UNIT-Electronics-MX/unit_pulsar_esp32_c5/tools/product-reference/chapters/00-description.md

## **Description**

The UNIT PULSAR ESP32-C5 is a multi-interface development board in the UNIT
DevLab ecosystem, built around the Espressif ESP32-C5HR8 SoC with 8 MB of
in-package PSRAM. The V1.2.3 design combines dual-band 2.4/5 GHz Wi-Fi 6,
Bluetooth LE, and IEEE 802.15.4 connectivity with external QSPI flash,
environmental and magnetic sensing, microSD, USB-C, Li-ion charging with fuel
gauging, an addressable RGB indicator, QWIIC I2C, and an RF coaxial antenna
connector.

### **Applications**

- Dual-band Wi-Fi 6, Bluetooth LE, Zigbee, and Thread prototyping
- Environmental monitoring and data logging
- Battery-powered IoT nodes with fuel gauging
- Magnetometer and proximity-based user interfaces
- microSD data logging
- Education and subsystem validation

### **Hardware Features**

- ESP32-C5HR8 SoC: 32-bit RISC-V up to 240 MHz, 384 KB HP SRAM, 8 MB PSRAM
- BY25Q64ES 64 Mbit (8 MiB) quad SPI NOR flash
- 2.4/5 GHz RF path through a diplexer to a coaxial antenna connector
- LPS22 pressure, FHT40 humidity/temperature, VCNL4040 proximity/light, and
  MMC5603NJ magnetometer sensors
- BQ24074 Li-ion charger with power path and MAX17048 fuel gauge
- SGM6029 1 A buck regulator for the 3.3 V rail
- microSD socket on SPI signals
- One WS2812 RGB LED plus power, charge, and user indicators
- USB-C, QWIIC, 6-pin SPI, battery, and Nano-style edge-pad connections
