UNIT-Electronics-MX/unit_pulsar_esp32_c5/tools/product-reference/chapters/02-ratings.md

## **2 Ratings**

This chapter defines the recommended operating conditions and electrical
characteristics of the UNIT PULSAR ESP32-C5 hardware V1.2.3. Ratings apply to
the complete board unless otherwise stated.

### **2.1 Recommended Operating Conditions** {.section-page}

The UNIT PULSAR ESP32-C5 can be powered from USB-C, VIN, or a single-cell LiPo
battery. The BQ24074 power-path charger feeds the onboard SGM6029 buck
regulator, which supplies the 3.3 V logic domain used by the ESP32-C5HR8 and
onboard peripherals.

| Parameter | Recommended operating condition | Notes |
|---|---:|---|
| USB-C input | 5 V nominal | Primary power and programming interface |
| VIN input | 5 V nominal | Joins USB VBUS through Schottky diode D4; board-level range not characterized |
| Battery input | 3.7 V nominal, 4.2 V maximum | Single-cell LiPo battery |
| Regulated logic rail | 3.3 V nominal | Generated by the onboard SGM6029 buck regulator |
| 3.3 V regulator output capability | Up to 1 A | SGM6029 component rating; shared by the SoC, peripherals, LEDs, and external 3.3 V loads |
| Battery charge current | 250 mA nominal | Set by R13 (3.57 kΩ) on the BQ24074 `ISET` pin |
| Input current limit | ≈1.4 A | Set by R12 (1.1 kΩ) on the BQ24074 `ILIM` pin |
| ESP32-C5 CPU clock | Up to 240 MHz | Firmware configurable |
| Main crystal | 48 MHz | XTAL1 |
| Internal SRAM | 384 KB HP SRAM, 16 KB LP SRAM | ESP32-C5 internal memory |
| External flash | 64 Mbit / 8 MiB | BY25Q64ESHIG |
| PSRAM | 8 MB | In-package, ESP32-C5HR8 |
| Logic level | 3.3 V | Applies to onboard digital interfaces and GPIO |

### **2.2 Power Domains and Power Distribution**

The UNIT PULSAR ESP32-C5 uses separate power domains for external supply,
battery operation, system power, and regulated 3.3 V logic.

The main power domains are:

- **USB-C / VBUS:** provides the nominal 5 V USB supply used for board power,
  programming, and battery charging. VBUS reaches the `+5V` node through
  Schottky diode D1 (SDM2U30CSP-7B, 2 A).

- **VIN:** external supply input that reaches the `+5V` node through Schottky
  diode D4 (SDM2U30CSP-7B, 2 A).

- **+5V:** input of the BQ24074 charger and power-path controller.

- **VBAT:** battery domain intended for a single-cell LiPo battery with a
  nominal voltage of 3.7 V and a maximum fully charged voltage of 4.2 V.

- **BMS_OUT:** BQ24074 power-path output used as the system supply and as the
  input of the 3.3 V buck regulator.

- **3.3 V:** regulated logic supply generated by the SGM6029. This rail powers
  the ESP32-C5HR8, external flash, sensors, fuel gauge, microSD interface,
  QWIIC and J20 connectors, RGB LED, and indicators.

The SGM6029 is rated for up to 1 A output current. This current is shared
between the ESP32-C5HR8, onboard peripherals, LEDs, and any external device
powered from the 3.3 V rail. Radio transmission produces short current peaks,
so the current available to external loads depends on the active board
configuration and application workload.

The BQ24074RGTR manages single-cell LiPo battery charging. The schematic
annotates a nominal charge current of 250 mA (`ICHRG=250mA`), set by R13. The
input current limit is set by R12. Both values may be changed by modifying the
corresponding resistor according to the BQ24074 configuration requirements.

All onboard digital interfaces operate in the 3.3 V logic domain. QWIIC, J20,
microSD, and exposed GPIO signals must therefore be used with 3.3 V-compatible
devices unless external level translation is provided.

Connector mechanical current ratings must not be interpreted as board power
ratings. Maximum usable current is also constrained by the associated PCB
traces, power path, regulator, protection components, and operating conditions.

### **2.3 Digital Interfaces**

All onboard digital peripherals are connected to the board's 3.3 V logic
domain. External logic compatibility must nevertheless be checked against the
ESP32-C5 input/output specifications and the power state of both devices.

| Interface | Board connection | Electrical note |
|---|---|---|
| Sensor I2C | GPIO2 / GPIO3 | Onboard sensors and fuel gauge; 4.7 kΩ pull-ups; strapping pins |
| QWIIC I2C | GPIO1 / GPIO6 | Connector also supplies 3.3 V and GND |
| SPI / microSD | GPIO27, GPIO7, GPIO26, GPIO23 | SCK, MOSI, MISO, microSD CS; shared with J20 |
| J20 chip select | GPIO10 | SS for an external SPI device |
| WS2812 data | GPIO0 | Drives the onboard RGB LED |
| UART0 | GPIO11 / GPIO12 | TX through 499 Ω series resistor |
| USB | GPIO13 / GPIO14 | Native USB Serial/JTAG |

### **2.4 Confirmed Component Values**

| Symbol / parameter | Value | Scope |
|---|---:|---|
| ESP32-C5 HP SRAM | 384 KB | ESP32-C5HR8 component |
| ESP32-C5 CPU clock | 240 MHz maximum | ESP32-C5HR8 component |
| In-package PSRAM | 8 MB | ESP32-C5HR8 component |
| QSPI flash capacity | 64 Mbit | IC3 |
| Buck output current | 1 A | U2 component rating |
| Charge current | 250 mA | R13 = 3.57 kΩ |
| Crystal frequency | 48 MHz | XTAL1 |
| Sensor I2C pull-ups | 4.7 kΩ | R15, R16 |

### **2.5 Application-Dependent and Uncharacterized Parameters** {.section-page}

Some electrical and performance characteristics depend on firmware
configuration, operating mode, connected peripherals, and application load.
Unless otherwise specified, these parameters should not be interpreted as
guaranteed board-level limits.

- **Available 3.3 V current for external loads:** the SGM6029 provides up to
  1 A total output current. This current is shared by the ESP32-C5HR8, radio
  transmission peaks, flash, sensors, LEDs, and external 3.3 V loads.

- **Board current consumption:** total current consumption varies with CPU
  activity, radio mode and transmit power, enabled peripherals, RGB LED
  brightness, microSD operation, and connected external devices.

- **RF performance:** radiated performance depends on the external antenna,
  cable, enclosure, and the populated matching network. It is not
  characterized at board level.

- **Low-battery operation:** the SGM6029 input is the BQ24074 system output.
  3.3 V regulation at low battery voltage is not characterized at board level.

- **GPIO electrical characteristics:** GPIO drive strength, input thresholds,
  and other pin-level electrical characteristics follow the ESP32-C5
  specifications unless a board-level circuit modifies the corresponding
  signal.

- **Environmental characteristics:** board-level operating temperature,
  humidity, ESD immunity, and thermal performance are not specified unless
  explicitly stated in a released qualification or validation specification.

### **2.6 Electrical Precautions** {.section-page}

1. Use only the specified power inputs: 5 V nominal through USB-C or VIN, or a
   3.7 V nominal / 4.2 V maximum single-cell LiPo battery.

2. All GPIO and onboard digital interfaces operate in the 3.3 V logic domain.
   **Do not apply 5 V directly to GPIO, QWIIC, J20, microSD, or other 3.3 V
   signal lines.**

3. Observe the battery connector polarity before connecting a single-cell LiPo
   battery. Do not connect multi-cell battery packs or batteries exceeding
   4.2 V. Do not connect batteries to JP1 and J3 at the same time; both
   connectors are wired in parallel.

4. Do not externally drive the 3.3 V rail while the onboard regulator is active
   unless the external power source and operating configuration have been
   specifically designed for this purpose.

5. Connect external circuits to a common ground before applying external clock,
   data, or control signals.

6. Do not hold GPIO2, GPIO3, GPIO7, GPIO25, GPIO26, GPIO27, or GPIO28 at a
   level that changes the boot configuration during reset; these are ESP32-C5
   strapping pins.

7. Connect an antenna to J2 before enabling radio transmission.

8. Ensure that the total load on the 3.3 V rail, including onboard circuitry
   and externally connected devices, remains within the 1 A capability of the
   SGM6029 regulator.
