UNIT-Electronics-MX/unit_pulsar_esp32_c5/tools/product-reference/chapters/08-references.md

## **8 Reference Documentation**

The following resources provide the official hardware, software, and
application documentation for the UNIT PULSAR ESP32-C5.

| Reference | Location |
|---|---|
| Product repository | [UNIT-Electronics-MX/unit_pulsar_esp32_c5](https://github.com/UNIT-Electronics-MX/unit_pulsar_esp32_c5) |
| Hardware reference | [hardware/README.md](https://github.com/UNIT-Electronics-MX/unit_pulsar_esp32_c5/blob/main/hardware/README.md) |
| Technical wiki | [PULSAR ESP32-C5 Wiki](https://github.com/UNIT-Electronics-MX/unit_pulsar_esp32_c5/wiki) |
| Board schematic | [Hardware V1.2.3 schematic](https://github.com/UNIT-Electronics-MX/unit_pulsar_esp32_c5/blob/main/hardware/unit_sch_v_1_2_3_ue0134_pulsar_esp32_c5.pdf) |
| ESP32-C5 component datasheet | [Espressif ESP32-C5 Series Datasheet](https://documentation.espressif.com/esp32-c5_datasheet_en.pdf) |
| Arduino core | [Espressif Arduino-ESP32](https://github.com/espressif/arduino-esp32) |

The UNIT Electronics Wiki provides application-oriented documentation, setup
procedures, peripheral usage examples, and software workflows for the board.

The hardware schematic and this Product Reference define the board-level
implementation, connections, power architecture, interfaces, and hardware
characteristics. ESP32-C5HR8 device-level electrical characteristics and
processor specifications should be referenced from the official Espressif
ESP32-C5 datasheet.
