UNIT-Electronics-MX/unit_pulsar_esp32_c5/docs/hardware/index.html

UNIT Electronics · DevLab

# UNIT PULSAR ESP32-C5

Direct links to hardware documentation and product files for use in external platforms.

26 files 12 images 7 formats 70.8 MB total

Search hardware resources

## Product documents

5 files

DOCX 934.2 KB

### Product Reference

Editable product reference

unit_product_reference_v_0_1_0_pulsar_esp32_c5.docx

Copy link Open file

PDF 1.1 MB

### Product Reference

Publication-ready product reference

unit_product_reference_v_0_1_0_pulsar_esp32_c5.pdf

Copy link Open file

PDF 187.7 KB

### Schematic

Electrical schematic

unit_sch_v_1_2_3_ue0134_pulsar_esp32_c5.pdf

Copy link Open file

PNG 605.3 KB

### Schematic

Electrical schematic

resources/unit_schematic_v_1_2_3_pulsar_esp32_c5_sheet_1.png

Copy link Open file

PNG 341.8 KB

### Schematic

Electrical schematic

resources/unit_schematic_v_1_2_3_pulsar_esp32_c5_sheet_2.png

Copy link Open file

## Pinouts

12 files

PDF 1.7 MB

### Pinout — English

Connector and signal reference in English

unit_btm_pinout_v1_2_3_ue0134_devlab_pulsar_esp32_c5_en.pdf

Copy link Open file

PDF 6.9 MB

### Pinout — English

Connector and signal reference in English

unit_pinout_v1_2_3_ue0134_devlab_pulsar_esp32_c5_en.pdf

Copy link Open file

PDF 5.3 MB

### Pinout — English

Connector and signal reference in English

unit_top_pinout_v1_2_3_ue0134_devlab_pulsar_esp32_c5_en.pdf

Copy link Open file

PNG 537.9 KB

### Pinout — English

Connector and signal reference in English

resources/unit_btm_pinout_v1_2_3_ue0134_devlab_pulsar_esp32_c5_en.png

Copy link Open file

PNG 4.5 MB

### Pinout — English

Connector and signal reference in English

resources/unit_pinout_v1_2_3_ue0134_devlab_pulsar_esp32_c5_en.png

Copy link Open file

PNG 805.6 KB

### Pinout — English

Connector and signal reference in English

resources/unit_top_pinout_v1_2_3_ue0134_devlab_pulsar_esp32_c5_en.png

Copy link Open file

PDF 1.7 MB

### Pinout — Spanish

Connector and signal reference in Spanish

unit_btm_pinout_v1_2_3_ue0134_devlab_pulsar_esp32_c5_es.pdf

Copy link Open file

PDF 4.8 MB

### Pinout — Spanish

Connector and signal reference in Spanish

unit_pinout_v1_2_3_ue0134_devlab_pulsar_esp32_c5_es.pdf

Copy link Open file

PDF 5.4 MB

### Pinout — Spanish

Connector and signal reference in Spanish

unit_top_pinout_v1_2_3_ue0134_devlab_pulsar_esp32_c5_es.pdf

Copy link Open file

PNG 546.6 KB

### Pinout — Spanish

Connector and signal reference in Spanish

resources/unit_btm_pinout_v1_2_3_ue0134_devlab_pulsar_esp32_c5_es.png

Copy link Open file

PNG 4.5 MB

### Pinout — Spanish

Connector and signal reference in Spanish

resources/unit_pinout_v1_2_3_ue0134_devlab_pulsar_esp32_c5_es.png

Copy link Open file

PNG 815.4 KB

### Pinout — Spanish

Connector and signal reference in Spanish

resources/unit_top_pinout_v1_2_3_ue0134_devlab_pulsar_esp32_c5_es.png

Copy link Open file

## Board views

5 files

PNG 1.5 MB

### Board Topology

Functional board layout

resources/unit_topology_v1_2_3_ue0134_devlab_pulsar_esp32_c5.png

Copy link Open file

PNG 940.6 KB

### Bottom View

Bottom-side board view

resources/unit_btm_v1_2_3_ue0134_devlab_pulsar_esp32_c5.png

Copy link Open file

PDF 349.4 KB

### Mechanical Dimensions

Board outline and dimensions

unit_dimensions_v1_2_3_ue0134_devlab_pulsar_esp32_c5.pdf

Copy link Open file

PNG 833.3 KB

### Mechanical Dimensions

Board outline and dimensions

resources/unit_dimensions_v1_2_3_ue0134_devlab_pulsar_esp32_c5.png

Copy link Open file

PNG 906.7 KB

### Top View

Top-side board view

resources/unit_top_v1_2_3_ue0134_devlab_pulsar_esp32_c5.png

Copy link Open file

## CAD and design files

2 files

IGES 12.5 MB

### 3D CAD Model

IGES mechanical model

resources/mechanics/unit_3d_v1_2_3_ue0134_devlab_pulsar_esp32_c5.iges

Copy link Open file

STEP 6.7 MB

### 3D CAD Model

STEP mechanical model

resources/mechanics/unit_3d_v1_2_3_ue0134_devlab_pulsar_esp32_c5.step

Copy link Open file

## Other resources

2 files

MD 7.4 KB

### Hardware README

Hardware overview and source notes

README.md

Copy link Open file

F3D 6.6 MB

### Unit 3D V1 2 3 Ue0134 Devlab Pulsar Esp32 C5

Hardware resource

resources/mechanics/unit_3d_v1_2_3_ue0134_devlab_pulsar_esp32_c5.f3d

Copy link Open file

No resources match your search.

UNIT Electronics hardware resources
