UNIT-Electronics-MX/unit_pulsar_esp32_c5/docs/hardware/resources/unit_top_pinout_v1_2_3_ue0134_devlab_pulsar_esp32_c5_es.png

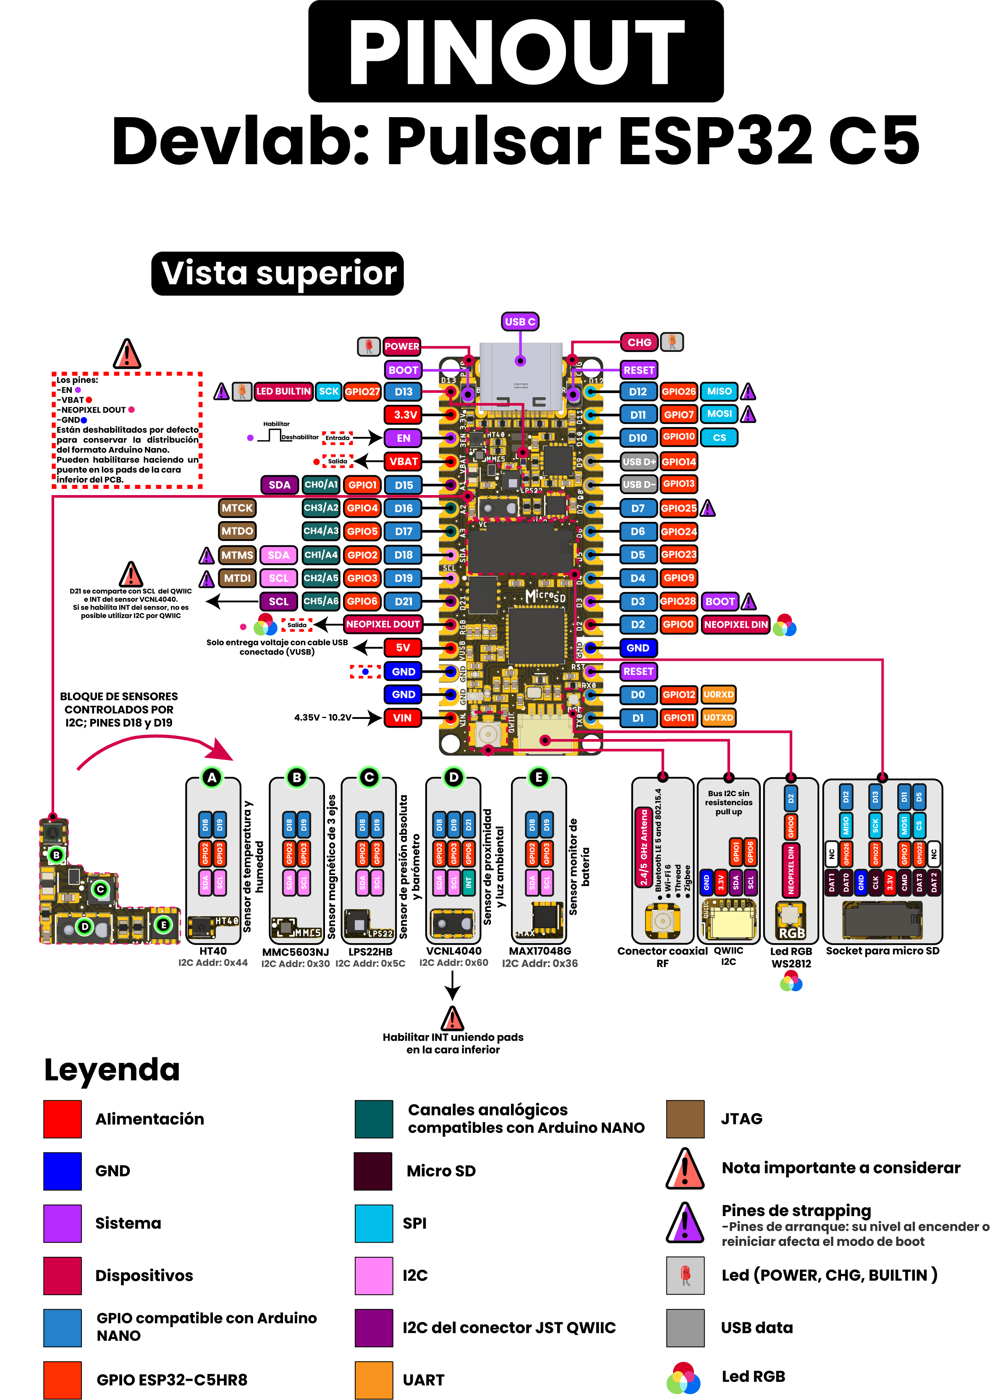
docs/hardware/resources/unit_top_pinout_v1_2_3_ue0134_devlab_pulsar_esp32_c5_es.png
