UNIT-Electronics-MX/unit_pulsar_esp32_c5/hardware/resources/unit_dimensions_v1_2_3_ue0134_devlab_pulsar_esp32_c5.png

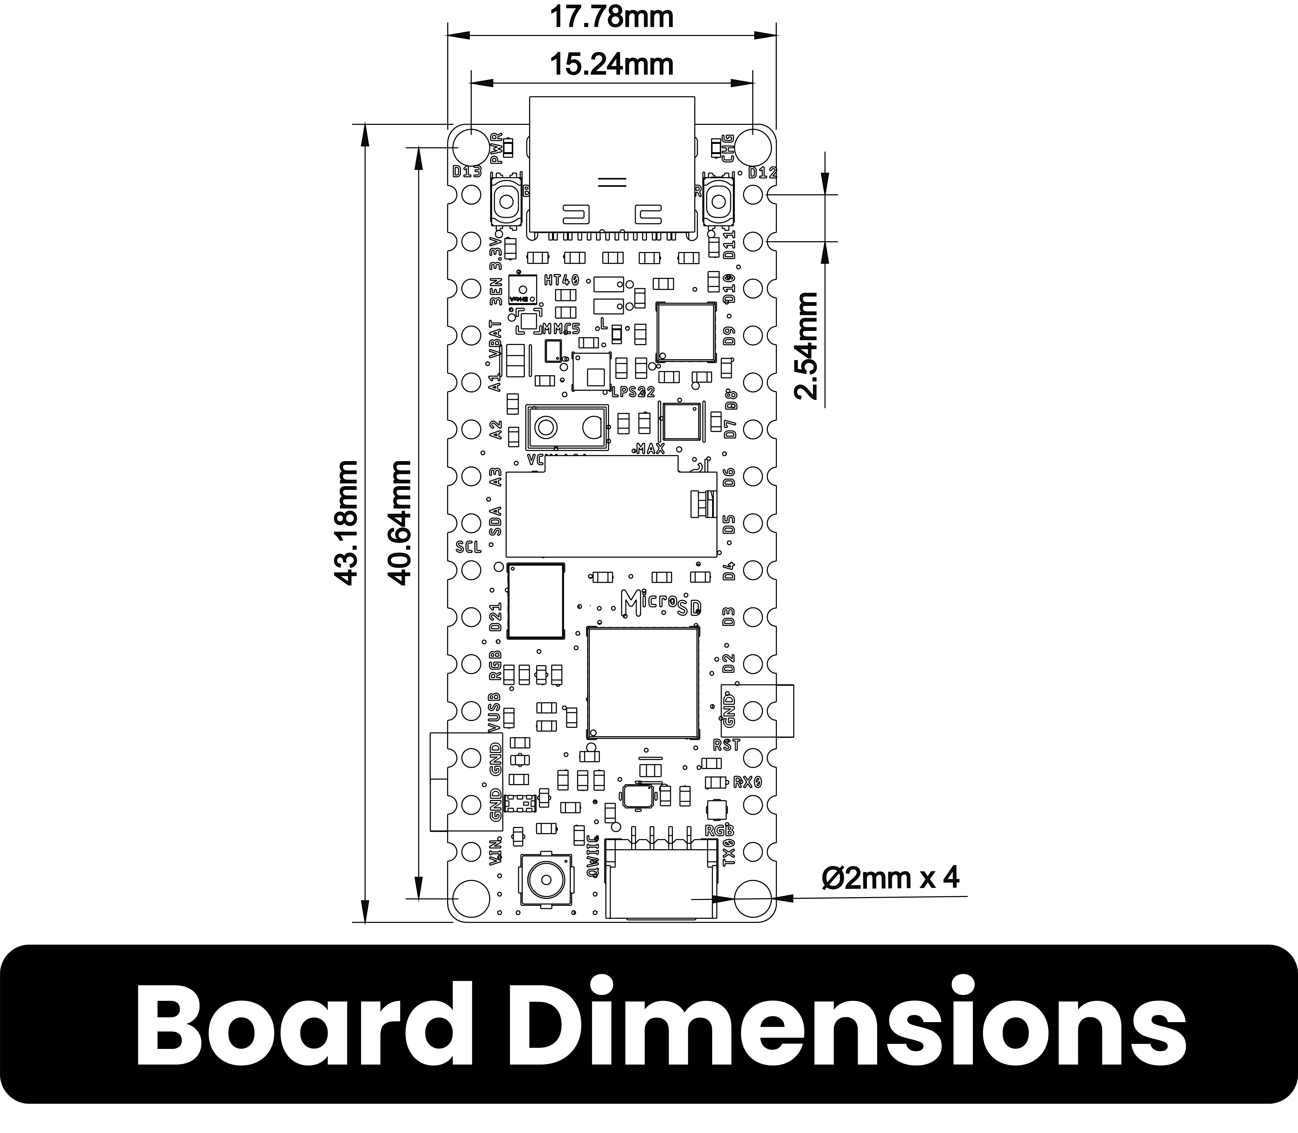
hardware/resources/unit_dimensions_v1_2_3_ue0134_devlab_pulsar_esp32_c5.png
