UNIT-Electronics-MX/unit_pulsar_esp32_c5/docs/hardware/resources/mechanics/unit_3d_v1_2_3_ue0134_devlab_pulsar_esp32_c5.step

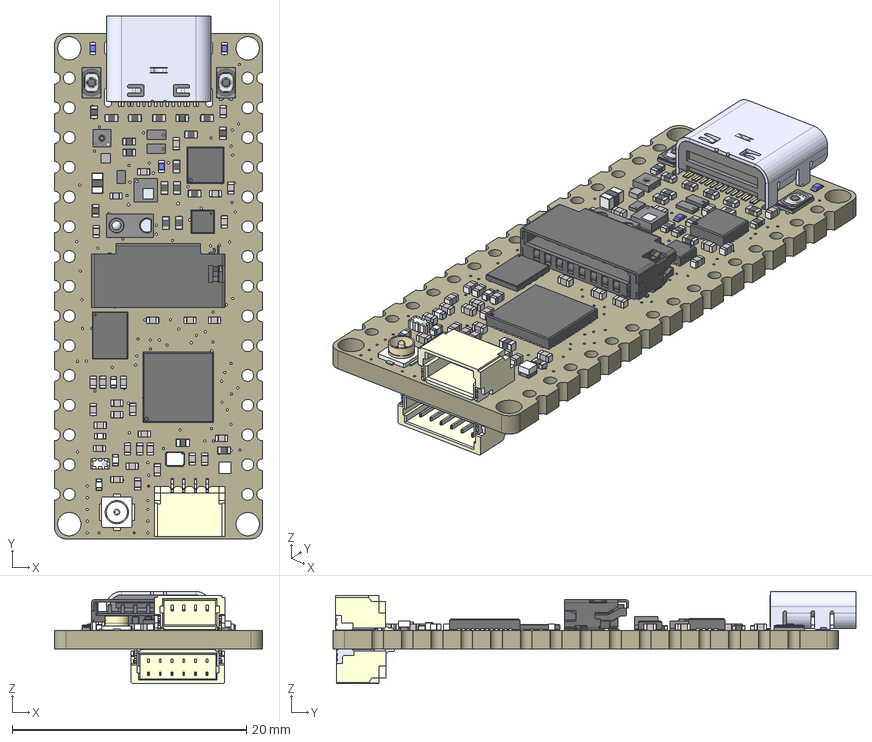
[picture p10: CAD file, 2026-11-13]
docs/hardware/resources/mechanics/unit_3d_v1_2_3_ue0134_devlab_pulsar_esp32_c5.step
17.8 x 44.7 x 7.88 mm
Placa
WLCSP-6_L1.0-W0.7-R2-C3-P0.35-BL~WLCSP-6_L1.0-W0.7-R2-C3-P0.35-BL~GQN I
SENSORS-SMD_VCNL4040M3OE~SENSORS-SMD_L4.0-W2.0-H1.1-P1.08~xvrE
USB_C_TYPE-C-31-M-12 v1
47309-2651 v1
SM04B-SRSS-TB(LF)(SN)--3DModel-STEP-56544 v1
IPEX-SMD_4P-L2.6-W2.6-LS3.0~IPEX-SMD_4P-L2.6-W2.6-LS3.0~v6XO
EVP-BB2A9B000 v1 x 2
XL-1010RGBC-WS2812B--3DModel-STEP-510211 v1
R0402 x 16
LPS22DFTR--3DModel-STEP-510211 v1
SHT40-AD1B-R2 v1
0402_R x 2
MMC5603NJ v1
SM06B-SRSS-TB(LF)(SN)--3DModel-STEP-269445
