UNIT-Electronics-MX/unit_pulsar_esp32_c5/(list of files, cad)

Other CAD files:
docs/hardware/resources/mechanics/unit_3d_v1_2_3_ue0134_devlab_pulsar_esp32_c5.f3d
docs/hardware/resources/mechanics/unit_3d_v1_2_3_ue0134_devlab_pulsar_esp32_c5.iges
