UNIT-Electronics-MX/unit_pulsar_esp32_c5/hardware/unit_btm_pinout_v1_2_3_ue0134_devlab_pulsar_esp32_c5_es.pdf

# Vista inferior

# PINOUT

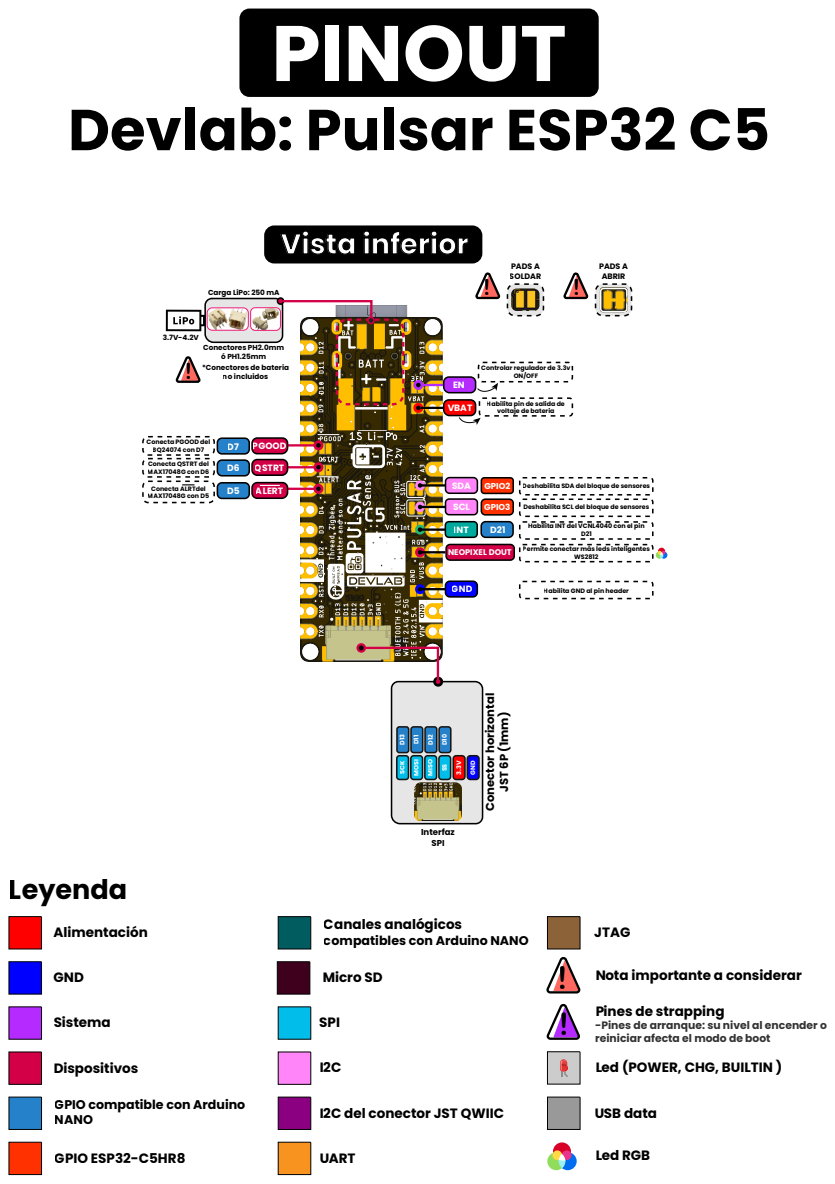
[picture p11: page 1]
EN VBAT; PADS A SOLDAR; Alimentación; GND; Sistema; SPI; USB data; UART; Led RGB; Conectores PH2.0mm ó PH1.25mm *Conectores de bateria no incluidos; Leyenda; Interfaz SPI; Devlab: Pulsar ESP32 C5 D¹² D¹⁰ 3.3V GND SS MISO D¹³ D¹¹ SCK MOSI; Conector horizontal JST 6P ⁽¹mm⁾; PGOOD; Carga LiPo: 250 mA; PADS A ABRIR; QSTRT; ALERT; SDA; SCL GPIO3; GPIO2; INT

Controlar regulador de 3.3v
ON/OFF

Habilita pin de salida de
voltaje de bateria

Conecta PGOOD del
BQ24074 con D7
D6 Conecta QSTRT del
MAX17048G con D6
D5 Conecta ALRTdel
MAX17048G con D5

Deshabilita SDA del bloque de sensores
Deshabilita SCL del bloque de sensores
Habilita INT del VCNL4040 con el pin

NEOPIXEL DOUT Permite conectar más leds inteligentes

Habilita GND al pin header

Canales analógicos
compatibles con Arduino NANO
Micro SD

JTAG
Nota importante a considerar
Pines de strapping
-Pines de arranque: su nivel al encender o
reiniciar afecta el modo de boot
Led (POWER, CHG, BUILTIN )

Dispositivos
GPIO compatible con Arduino
NANO
GPIO ESP32-C5HR8

I2C del conector JST QWIIC
