UNIT-Electronics-MX/unit_pulsar_esp32_c5/hardware/unit_pinout_v1_2_3_ue0134_devlab_pulsar_esp32_c5_es.pdf

### PADS A SOLDAR

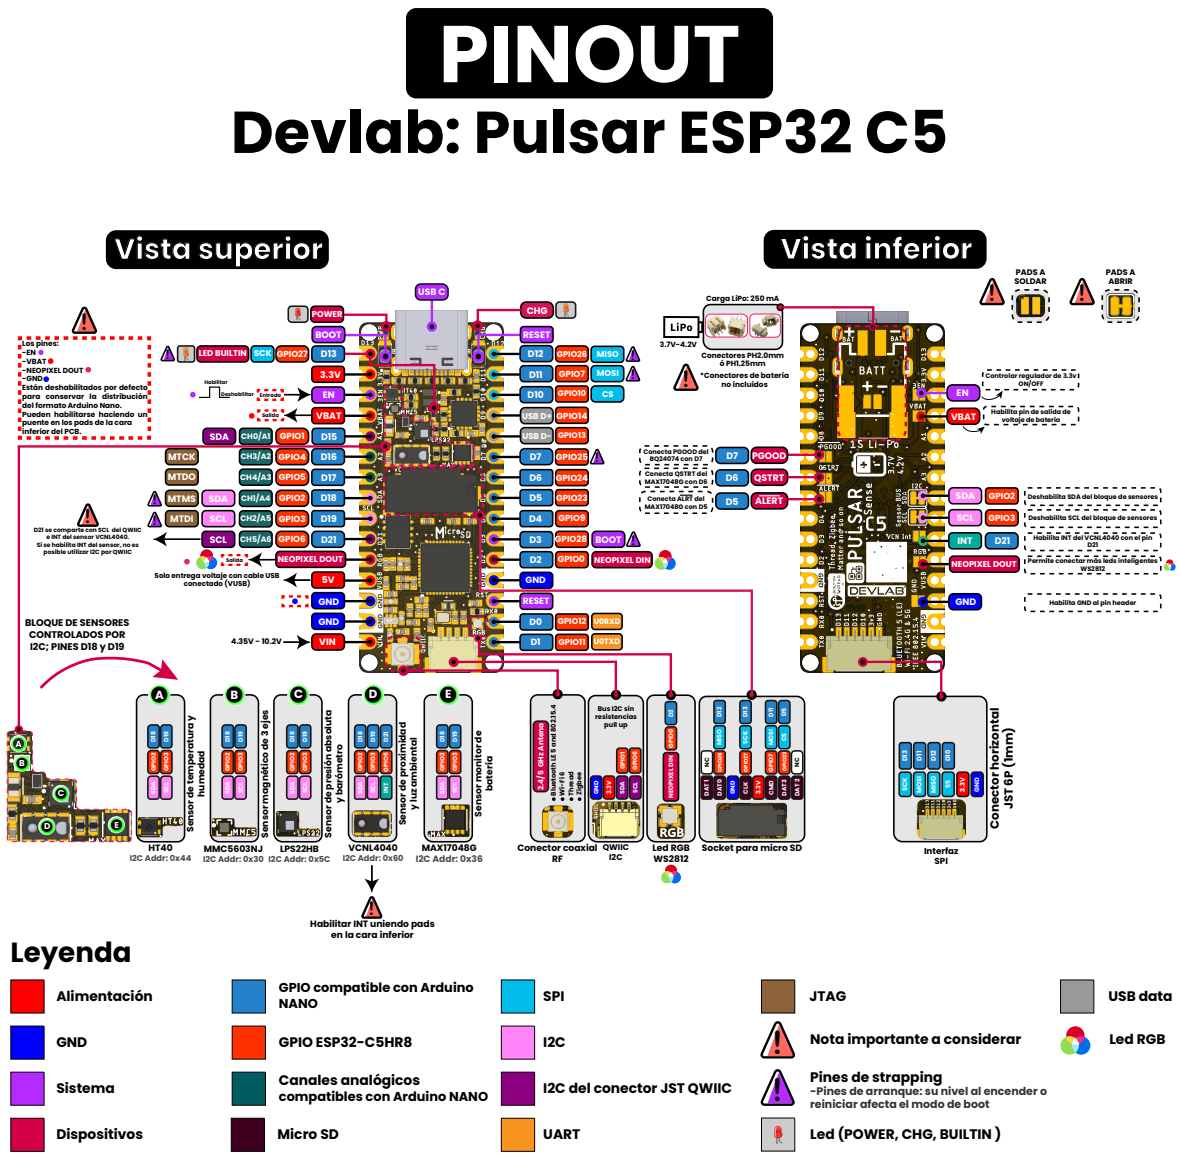
[picture p12: page 1]

PINOUT
Devlab: Pulsar ESP32 C5 GPIO⁰ D² NEOPIXEL DIN GPIO² GPIO³ SDA SCL D¹⁸ D¹⁹

Los pines:
-VBAT
-NEOPIXEL DOUT
-GND
Están deshabilitados por defecto
para conservar la distribución
del formato Arduino Nano.
Pueden habilitarse haciendo un
puente en los pads de la cara
inferior del PCB.

Habilita pin de salida de
voltaje de bateria

Deshabilita SDA del bloque de sensores

Deshabilita SCL del bloque de sensores
Habilita INT del VCNL4040 con el pin

D21 se comparte con SCL del QWIIC
e INT del sensor VCNL4040.
Si se habilita INT del sensor, no es
posible utilizar I2C por QWIIC

NEOPIXEL DOUT Permite conectar más leds inteligentes

Solo entrega voltaje con cable USB
conectado (VUSB)

Habilita GND al pin header

Sensor magnético de 3 ejes

Led RGB Socket para micro SD

Habilitar INT uniendo pads

NANO
GPIO ESP32-C5HR8
Canales analógicos
compatibles con Arduino NANO

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

I2C del conector JST QWIIC
