UNIT-Electronics-MX/unit_pulsar_esp32_c5/docs/hardware/unit_btm_pinout_v1_2_3_ue0134_devlab_pulsar_esp32_c5_en.pdf

### PADS TO SOLDER

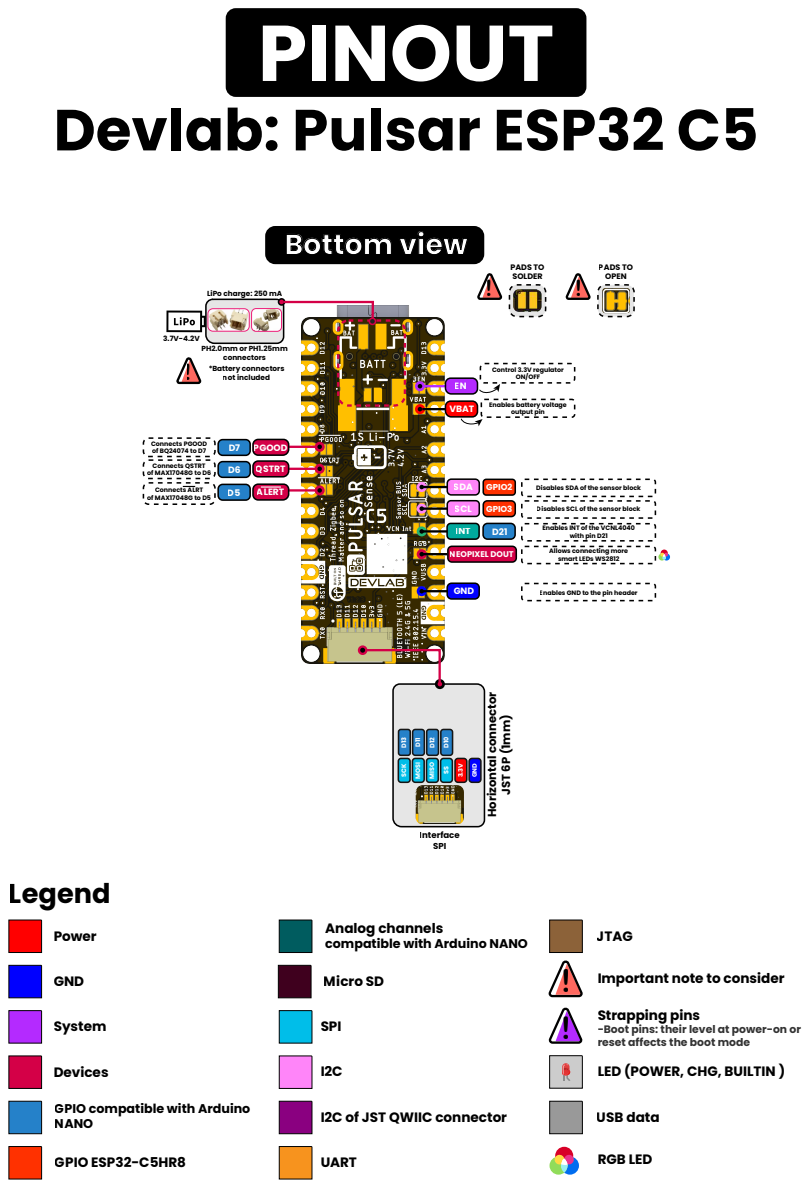
[picture p13: page 1]
EN VBAT; Control 3.3V regulator ON/OFF; Connects PGOOD of BQ24074 to D7 D6 Connects QSTRT of MAX17048G to D6; D5 Connects ALRT of MAX17048G to D5; Power; GND; System; SPI; USB data; UART; RGB LED; NEOPIXEL DOUT; Allows connecting more; smart LEDs WS2812; PH2.0mm or PH1.25mm connectors *Battery connectors not included; Legend; Interface SPI; Bottom view; PINOUT; Devlab: Pulsar ESP32 C5 D¹² D¹⁰ 3.3V GND SS MISO D¹³ D¹¹ SCK MOSI; Horizontal connector JST 6P ⁽¹mm⁾; PGOOD; LiPo charge: 250 mA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

Enables battery voltage
output pin

Disables SDA of the sensor block
Disables SCL of the sensor block
Enables INT of the VCNL4040
with pin D21

Enables GND to the pin header

Analog channels
compatible with Arduino NANO
Micro SD

JTAG
Important note to consider
Strapping pins
-Boot pins: their level at power-on or
reset affects the boot mode
LED (POWER, CHG, BUILTIN )

Devices
GPIO compatible with Arduino
NANO
GPIO ESP32-C5HR8

I2C of JST QWIIC connector
