UNIT-Electronics-MX/unit_pulsar_esp32_c5/docs/hardware/unit_dimensions_v1_2_3_ue0134_devlab_pulsar_esp32_c5.pdf

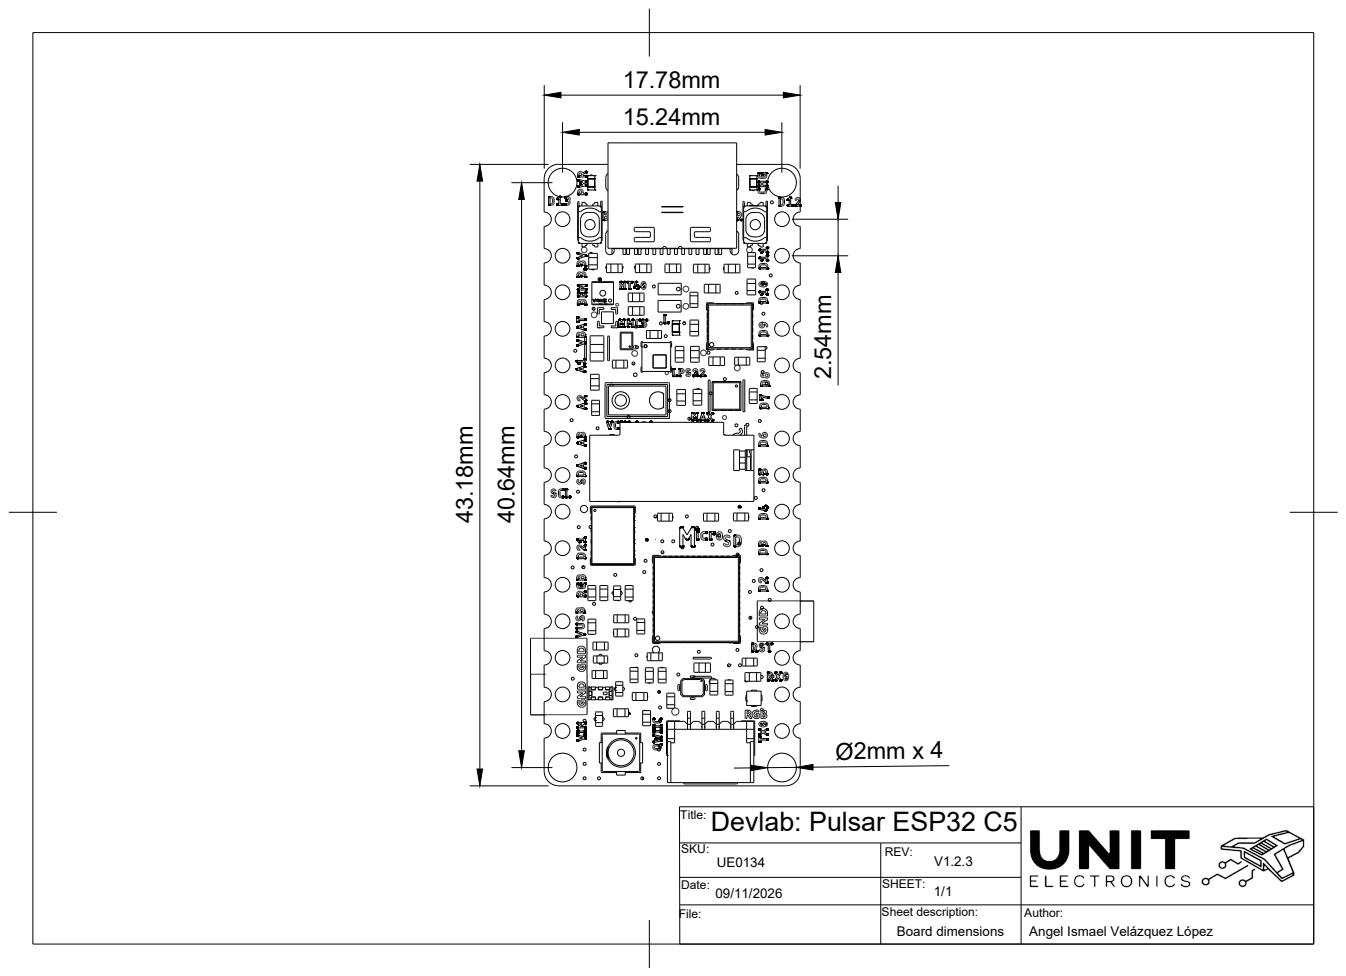
[picture p14: page 1]
File:; Sheet description:; Board dimensions; Devlab: Pulsar ESP32 C5

Author:
Angel Ismael Velázquez López
