UNIT-Electronics-MX/unit_pulsar_esp32_c5/docs/hardware/unit_pinout_v1_2_3_ue0134_devlab_pulsar_esp32_c5_en.pdf

### PADS TO SOLDER

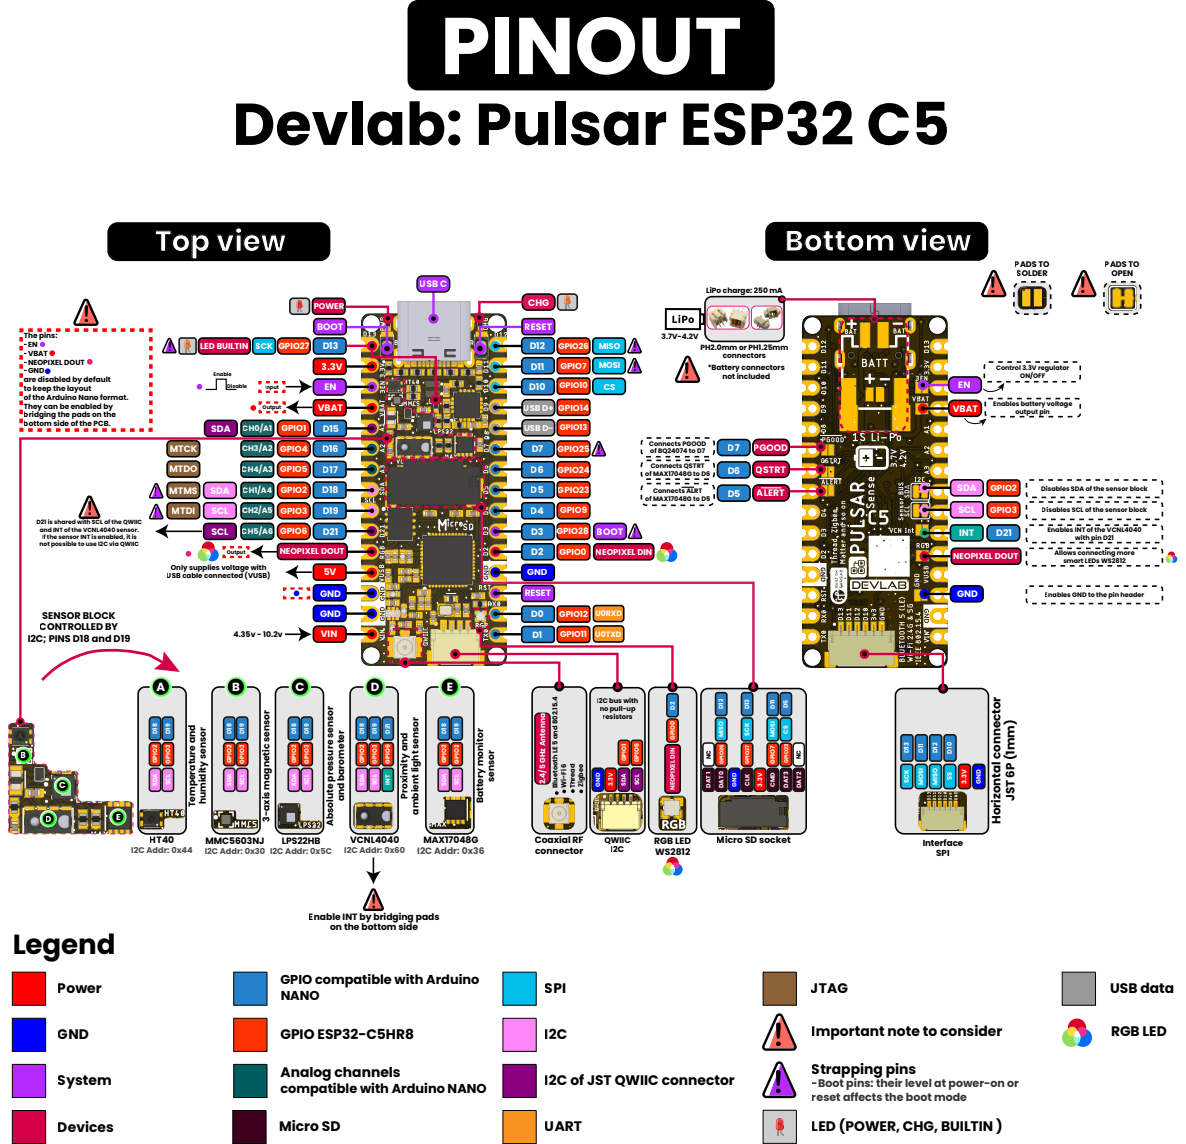
[picture p15: page 1]

PINOUT
Devlab: Pulsar ESP32 C5 GPIO⁰ D² NEOPIXEL DIN GPIO² GPIO³ SDA SCL D¹⁸ D¹⁹

The pins:
-VBAT
-NEOPIXEL DOUT
-GND
are disabled by default
to keep the layout
of the Arduino Nano format.
They can be enabled by
bridging the pads on the
bottom side of the PCB.

Disables SDA of the sensor block

Disables SCL of the sensor block
Enables INT of the VCNL4040
with pin D21

D21 is shared with SCL of the QWIIC
and INT of the VCNL4040 sensor.
If the sensor INT is enabled, it is
not possible to use I2C via QWIIC

Only supplies voltage with
USB cable connected (VUSB)

Enables GND to the pin header

Enable INT by bridging pads

NANO
GPIO ESP32-C5HR8
Analog channels
compatible with Arduino NANO

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

I2C of JST QWIIC connector
