UNIT-Electronics-MX/unit_pulsar_esp32_c5/docs/hardware/unit_sch_v_1_2_3_ue0134_pulsar_esp32_c5.pdf

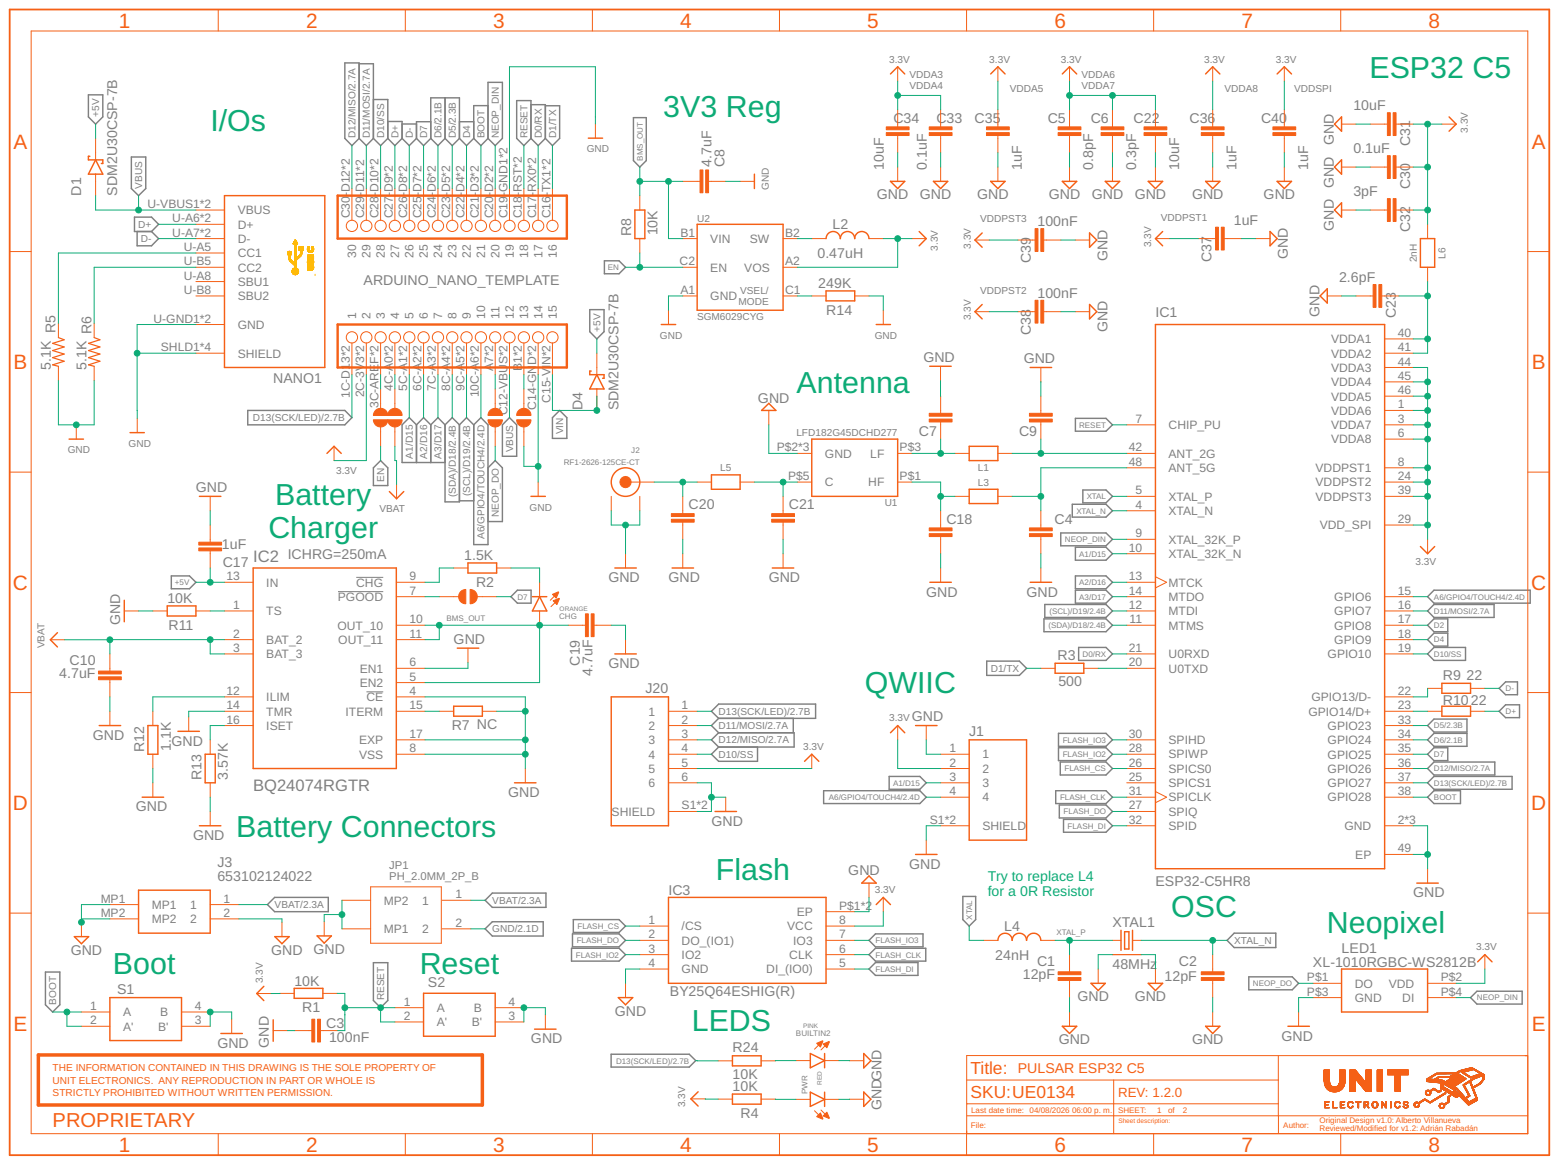
[picture p16: page 1]

THE INFORMATION CONTAINED IN THIS DRAWING IS THE SOLE PROPERTY OF UNIT ELECTRONICS. ANY REPRODUCTION IN PART OR WHOLE IS

Original Design v1.0: Alberto Villanueva Reviewed/Modified for v1.2: Adrián Rabadán PULSAR ESP32 C5

STRICTLY PROHIBITED WITHOUT WRITTEN PERMISSION. PROPRIETARY

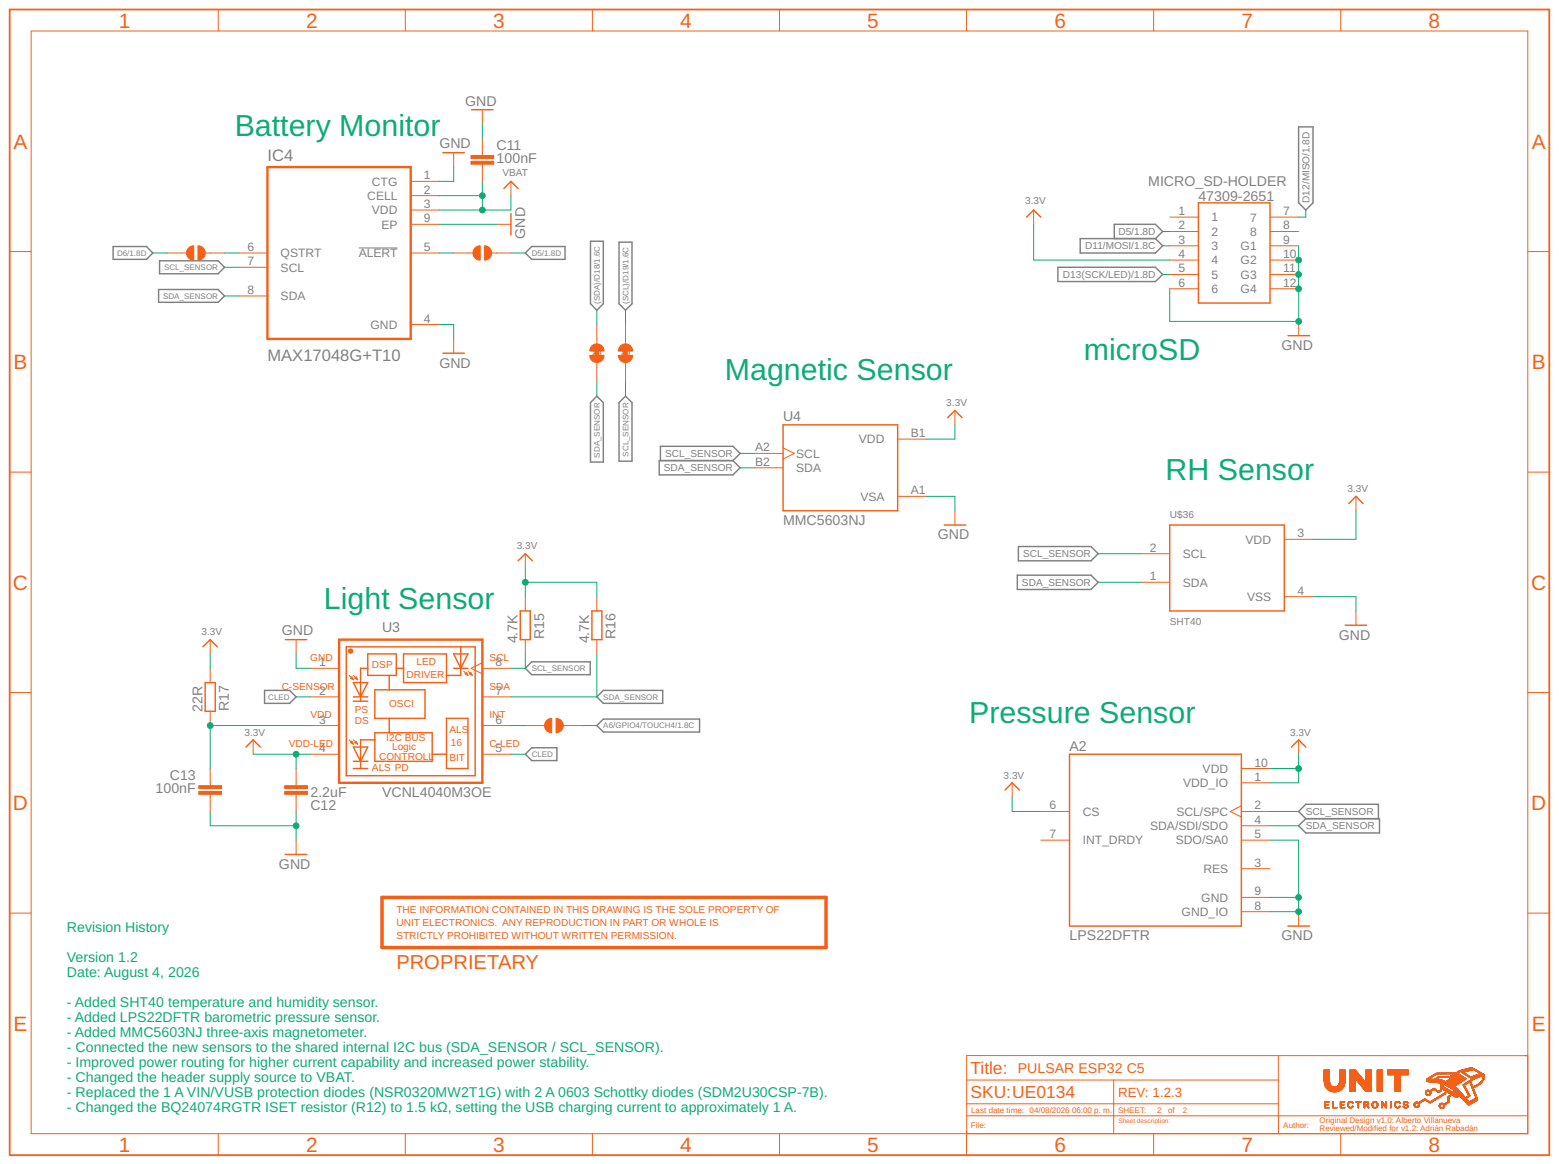
[picture p17: page 2]
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

Revision History
Version 1.2
Date: August 4, 2026
- Added SHT40 temperature and humidity sensor. - Added LPS22DFTR barometric pressure sensor. - Added MMC5603NJ three-axis magnetometer. - Connected the new sensors to the shared internal I2C bus (SDA_SENSOR / SCL_SENSOR). - Improved power routing for higher current capability and increased power stability. - Changed the header supply source to VBAT. - Replaced the 1 A VIN/VUSB protection diodes (NSR0320MW2T1G) with 2 A 0603 Schottky diodes (SDM2U30CSP-7B). - Changed the BQ24074RGTR ISET resistor (R12) to 1.5 kΩ, setting the USB charging current to approximately 1 A.

STRICTLY PROHIBITED WITHOUT WRITTEN PERMISSION. PROPRIETARY

PULSAR ESP32 C5 | Author:
SKU: UE0134 Last date time: | 1.2.3 REV: SHEET: Sheet description: of File:

Original Design v1.0: Alberto Villanueva Reviewed/Modified for v1.2: Adrián Rabadán
