UNIT-Electronics-MX/unit_pulsar_esp32_c5/(commit log)

2026-09-25 ref: rework hardware docs and Product Reference for ESP32-C5
    Replace the RP2350 content inherited from the template with the
    UNIT PULSAR ESP32-C5 (UE0134) hardware, based on the V1.2.3
    schematic, BOM, and Espressif ESP32-C5 datasheet.
    - Update README board description and overview table
    - Add component, pinout, interface, analog, and board-resource tables
    - Document sensor I2C addresses, topology, connectors, and functions
    - Rewrite Product Reference chapters 00-09 for the ESP32-C5
    - Document RF path, antenna, BQ24074/SGM6029 power, onboard sensors,
    MAX17048 fuel gauge, QWIIC, J20 SPI, microSD, and strapping pins
    - Add Arduino-ESP32 workflow
    - Add V1.2.3 schematic PDF and rendered schemat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
2026-09-28 docs: update esp32 c5 docs
